ChrisFrancoHansen/Alarm-Clock-Project/FINAL project/Group_1-Circuit_Schematic.pdf.pdf

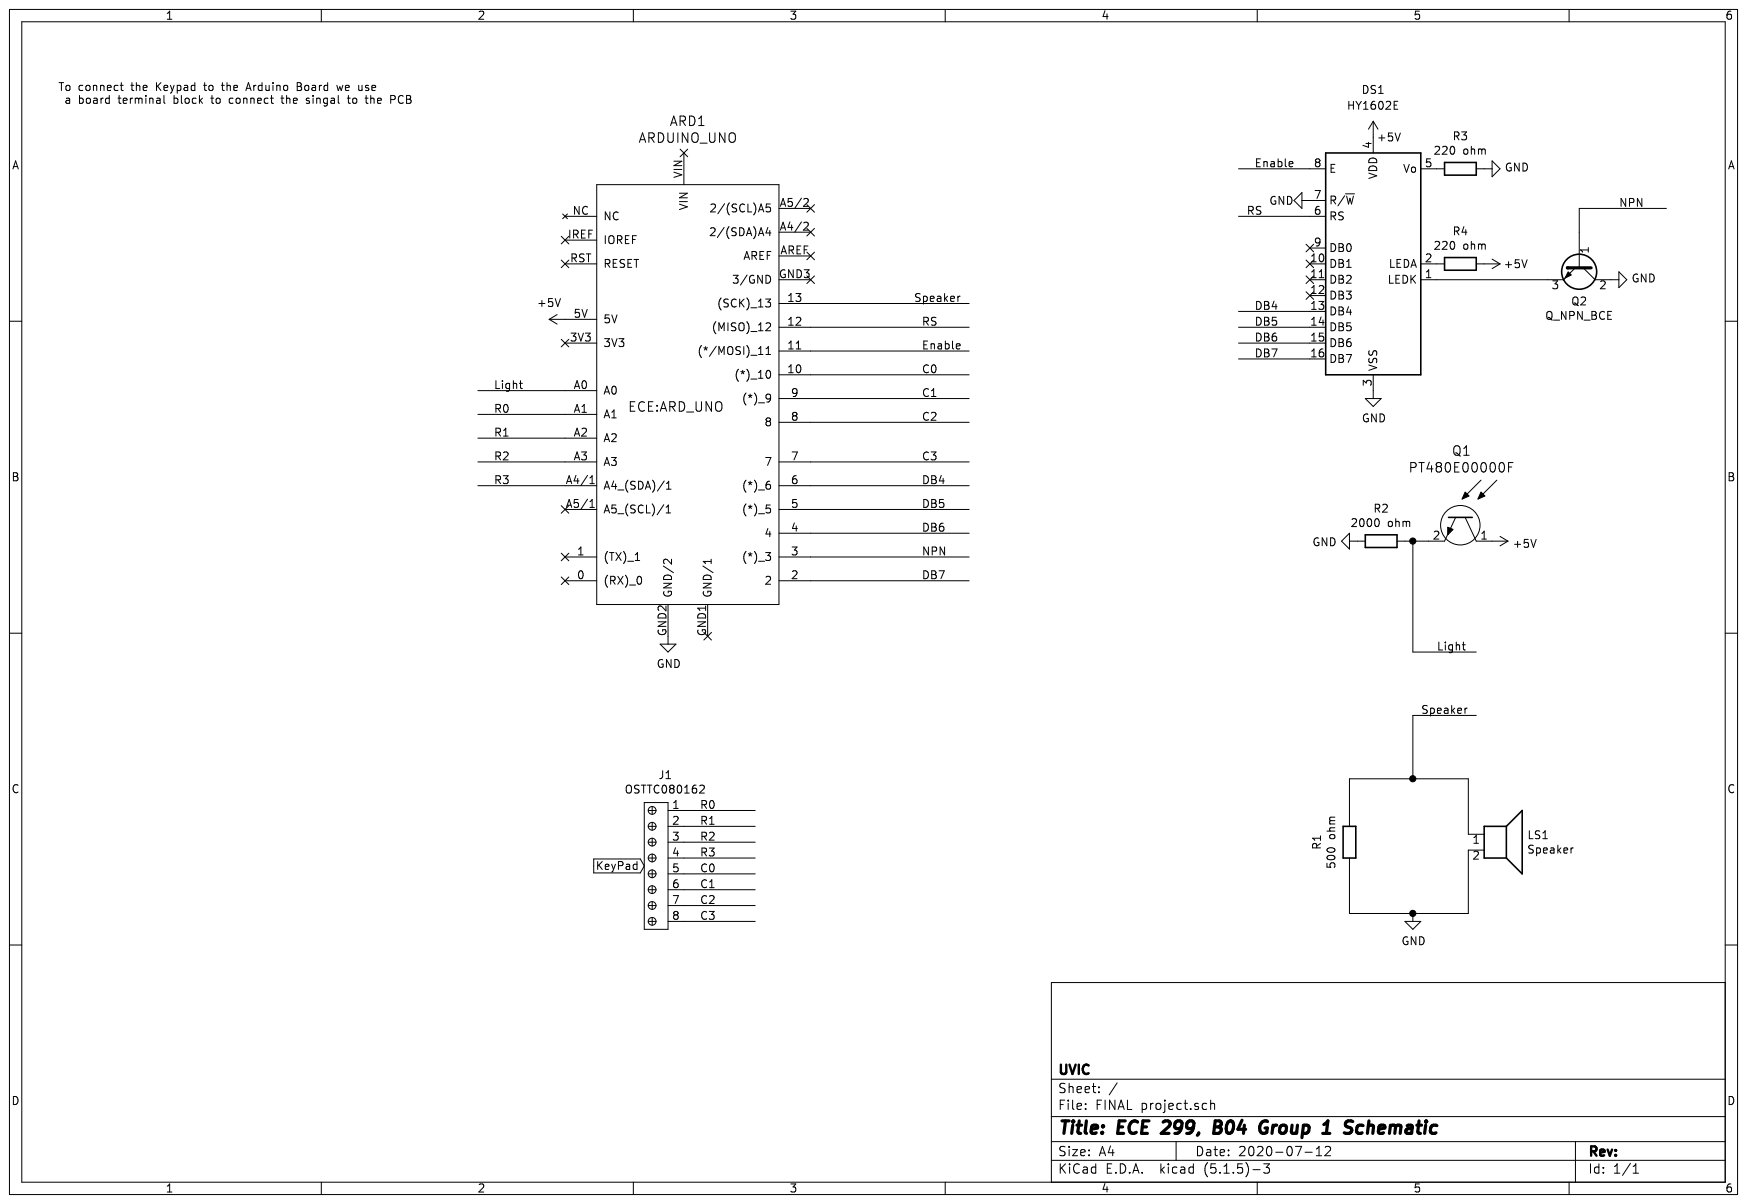
[picture p19: page 1]
